Tejaji-0/openseasame/OpenSeasame_case.step

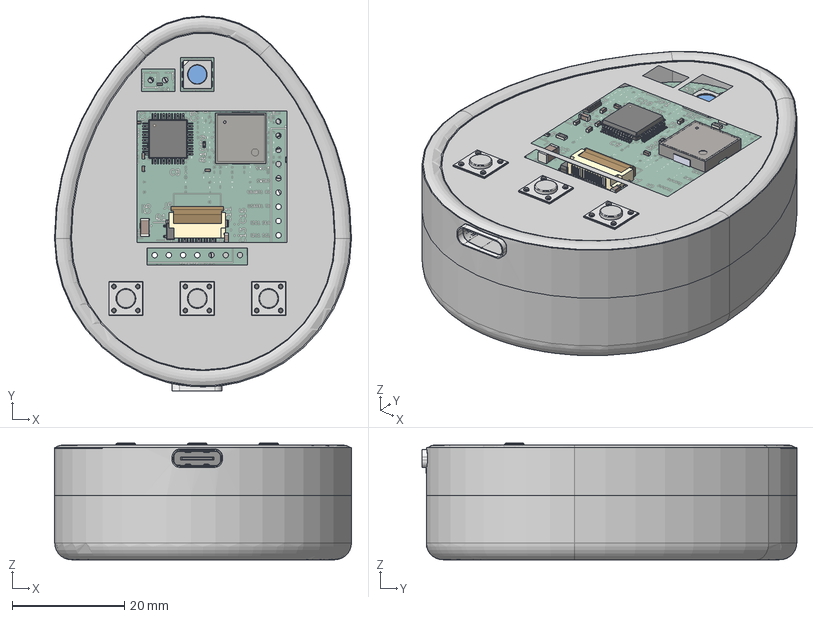
[picture p1: CAD file, 2025-12-24]
OpenSeasame_case.step
53.0 x 66.9 x 20.8 mm
C_1206_3216Metric x 3
C_0603_1608Metric x 4
C_0402_1005Metric x 9
LED_RGB_5050-6
ConPins
PcbPins
Mold
Frame
SOT-23 x 3
R_0402_1005Metric x 17
R_0603_1608Metric x 6
Tactal Switch -Thru (6mmx 6mmx4.3mm) x 3
SOT-23-5
TSOT-23-5
Crystal_SMD_3215-2Pin_3.2x1.5mm
CPT-9019S-SMT-TR--3DModel-STEP-1
L_0402_1005Metric
LQFP-48_7x7mm_P0.5mm
SOT-23-6
lock
pins
OpenSeasame_silkscreen
OpenSeasame_soldermask
OpenSeasame_PCB
