Tejaji-0/openseasame/OpenSeasame_caseonly.step

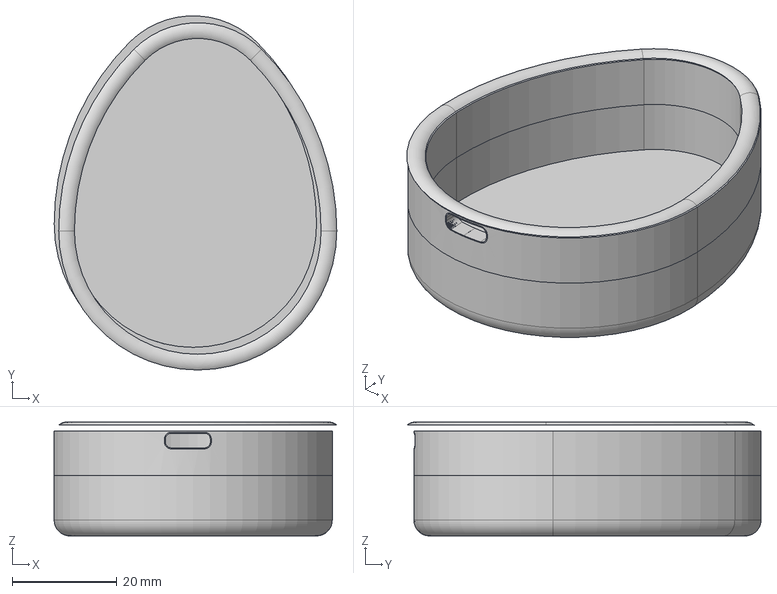
[picture p2: CAD file, 2025-11-26]
OpenSeasame_caseonly.step
53.9 x 67.5 x 21.7 mm
