Tejaji-0/openseasame/(list of files, cad)

Other CAD files:
OpenSeasame-pcb.step
