Tejaji-0/openseasame/(commit log)

2025-11-14 Update BOM.csv with new component details
    Updated component details in BOM.csv to reflect new part numbers and footprints.
    [BOM.csv]
2025-11-26 Update README to include 3D case information
    Added information about the included 3D case and .step files.
2025-11-27 Update README with case and PCB links
    Added links to case and PCB files in the README.
2025-12-24 Update OpenSeasame_case.step
    Made the case work
    [OpenSeasame_case.step]
