Tejaji-0/openseasame/(notices)

Notices in the files:
OpenSeasame.kicad_sch:
Licensed under CERN-OHL-S v2
